115ek/blink1/hardware/schematic/Richtig_Guter_Blinker/Richtig_Guter_Blinker.kicad_pcb

## KiCad design hardware/schematic/Richtig_Guter_Blinker/Richtig_Guter_Blinker.kicad_pcb (2019-05-07)

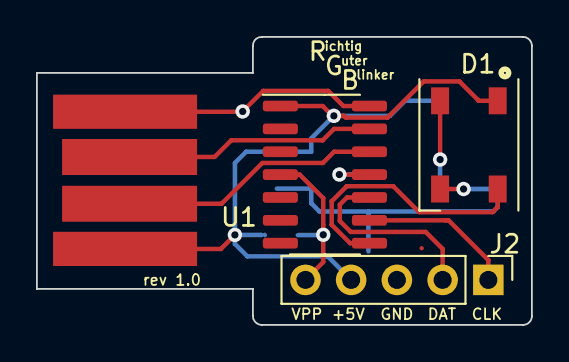
[picture p6: board Richtig_Guter_Blinker.kicad_pcb from above]

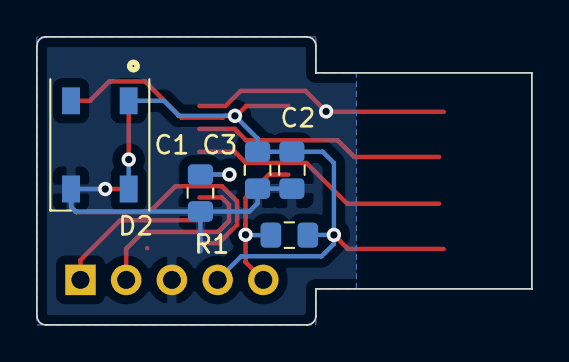
[picture p7: board Richtig_Guter_Blinker.kicad_pcb from below]

Board: 2 copper layers, 27.5 x 16.0 mm, 9 parts (5 on the bottom side), 10 nets.

Parts:
C1, C3: 100nF; C_0805_2012Metric_Pad1.15x1.40mm_HandSolder
C2: 10uF; C_0805_2012Metric_Pad1.15x1.40mm_HandSolder
D1, D2: WS2812B; LED_WS2812B_PLCC4_5.0x5.0mm_P3.2mm
J1: USB_A; usb-PCB
J2: Conn_01x05_Male; PinHeader_1x05_P2.54mm_Vertical
R1: 10k; R_0805_2012Metric_Pad1.15x1.40mm_HandSolder
U1: PIC16F1455-ISL; SOIC-14_3.9x8.7mm_P1.27mm

Connections:
+5V: C2.1, C3.1, D1.1, D2.1, J1.1, J2.4, R1.2, U1.1
D+: J1.3, U1.13
D-: J1.2, U1.12
DI: D1.4, U1.8
GND: C1.2, C2.2, C3.2, D1.3, D2.3, J1.4, J2.3, U1.14
ICSPCLK: J2.1, U1.9
ICSPDAT: J2.2, U1.10
unnamed: C1.1, U1.11
unnamed: D1.2, D2.4
VPP: J2.5, R1.1, U1.4
